jmgjmg/ArduRadio/images/Proto2.jpg

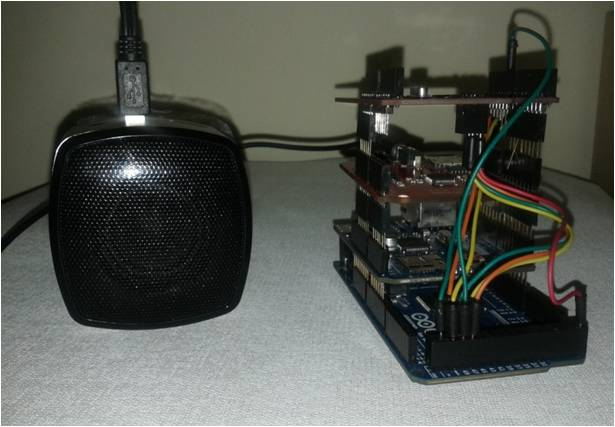
images/Proto2.jpg
