jmgjmg/ArduRadio/images/Proto4.jpg

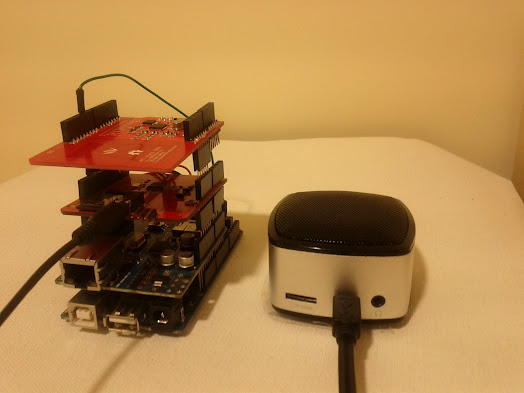
images/Proto4.jpg
