jmgjmg/ArduRadio/images/Proto3.jpg

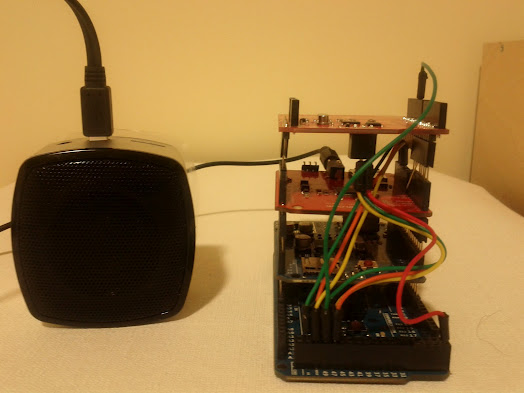
images/Proto3.jpg
